stash-s/FunkNetzWerkUhr/README.md

# FunkNetzWerkUhr
ESP8266 IN-12 Nixie lamp netwok clock
