stash-s/FunkNetzWerkUhr/kicad/ausf_b/output/nixie-breakout-F.Cu.dxf

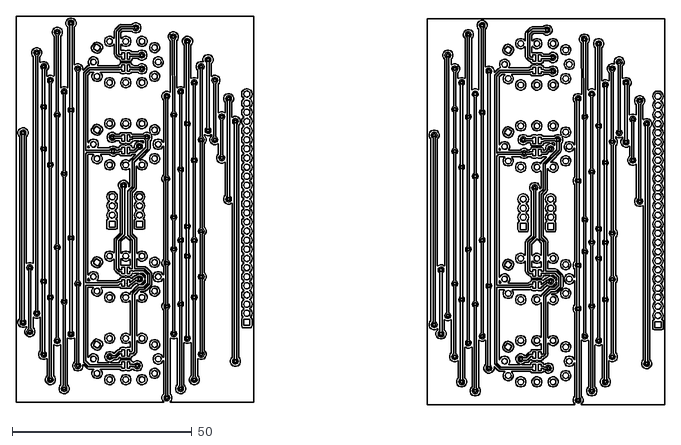
[picture p1: CAD file, 2018-07-26]
kicad/ausf_b/output/nixie-breakout-F.Cu.dxf
180.3 x 107.9
