stash-s/FunkNetzWerkUhr/kicad/ausf_b/output/hv_psu-hv_psu.pdf

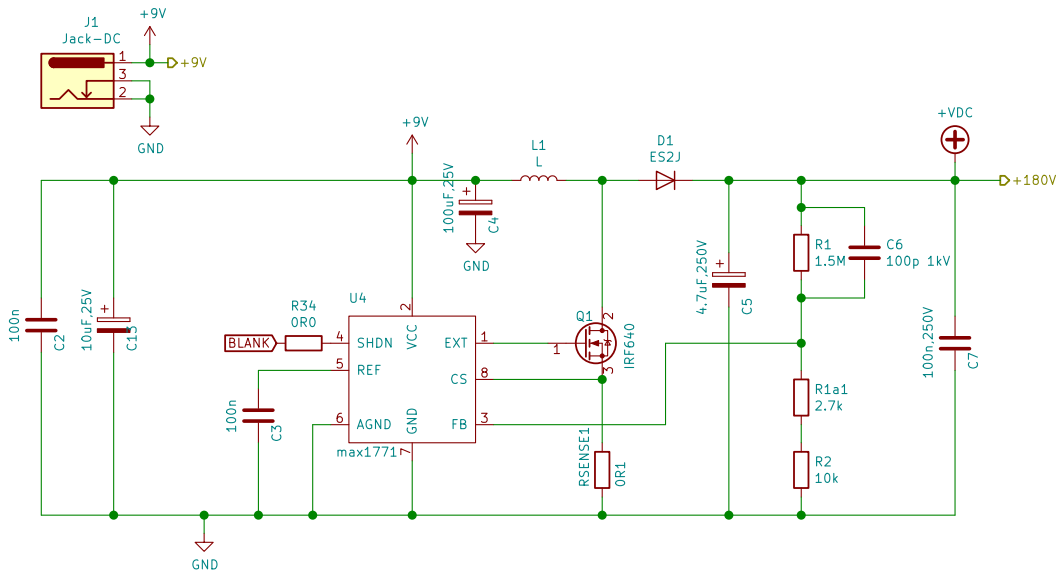
[picture p3: page 1]

2 FB 3 SHDN 4 REF 5 AGND 6 GND
