stash-s/FunkNetzWerkUhr/kicad/ausf_b/output/front_panel-front_panel.pdf

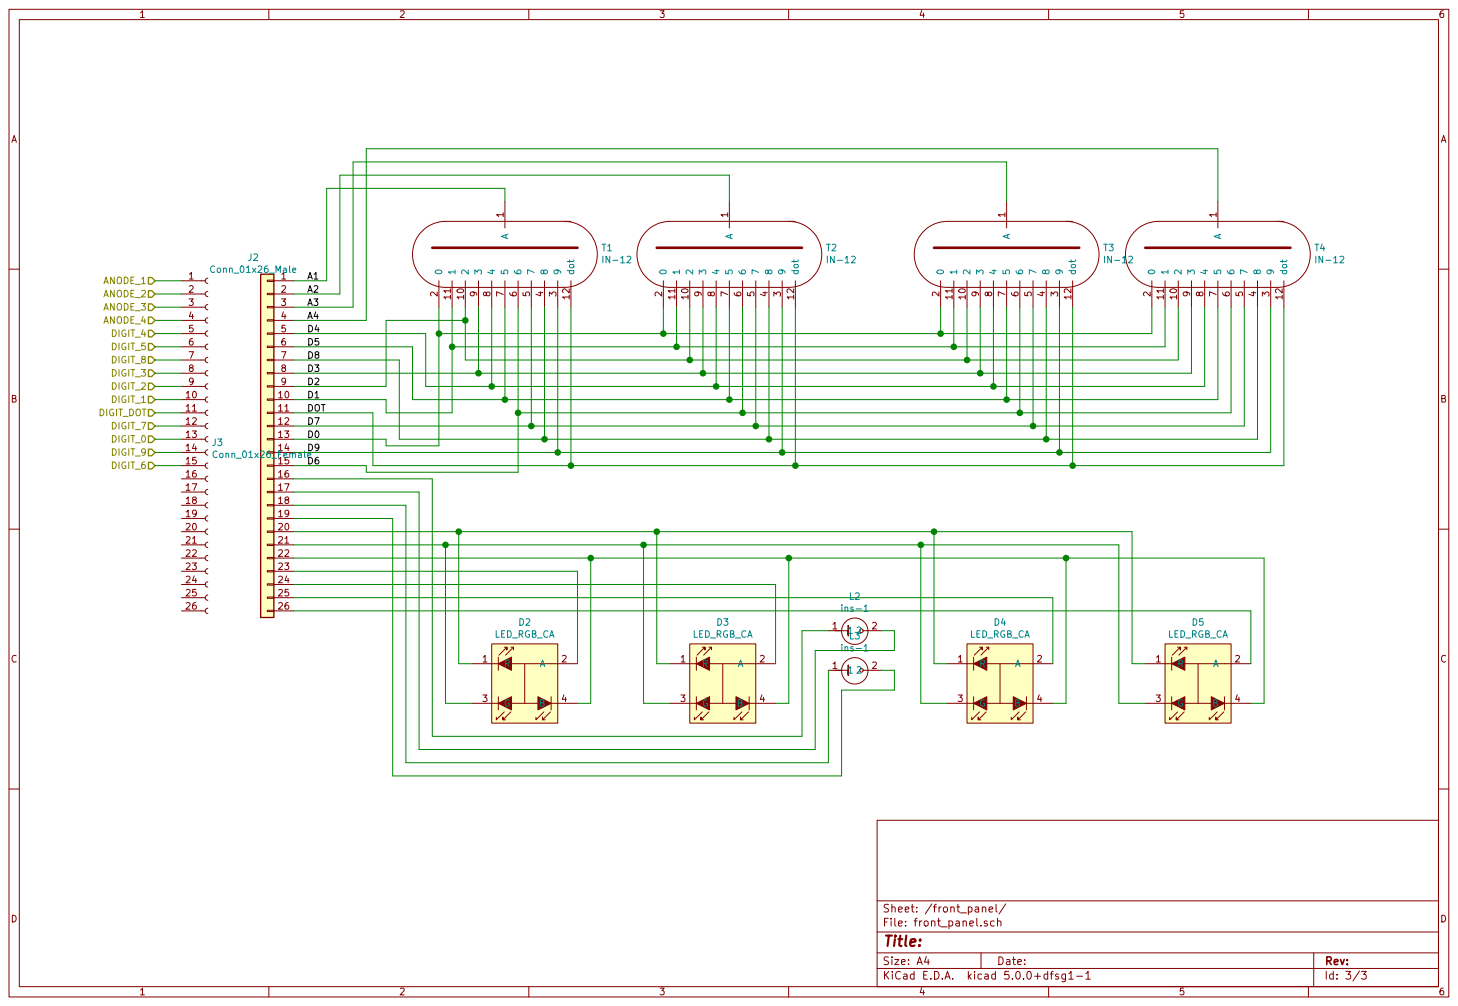
[picture p4: page 1]

21
22
23 | L2
24
25
26 | | ins-1
