stash-s/FunkNetzWerkUhr/kicad/ausf_b/output/funknetzwerkuhr-F.SilkS.pdf

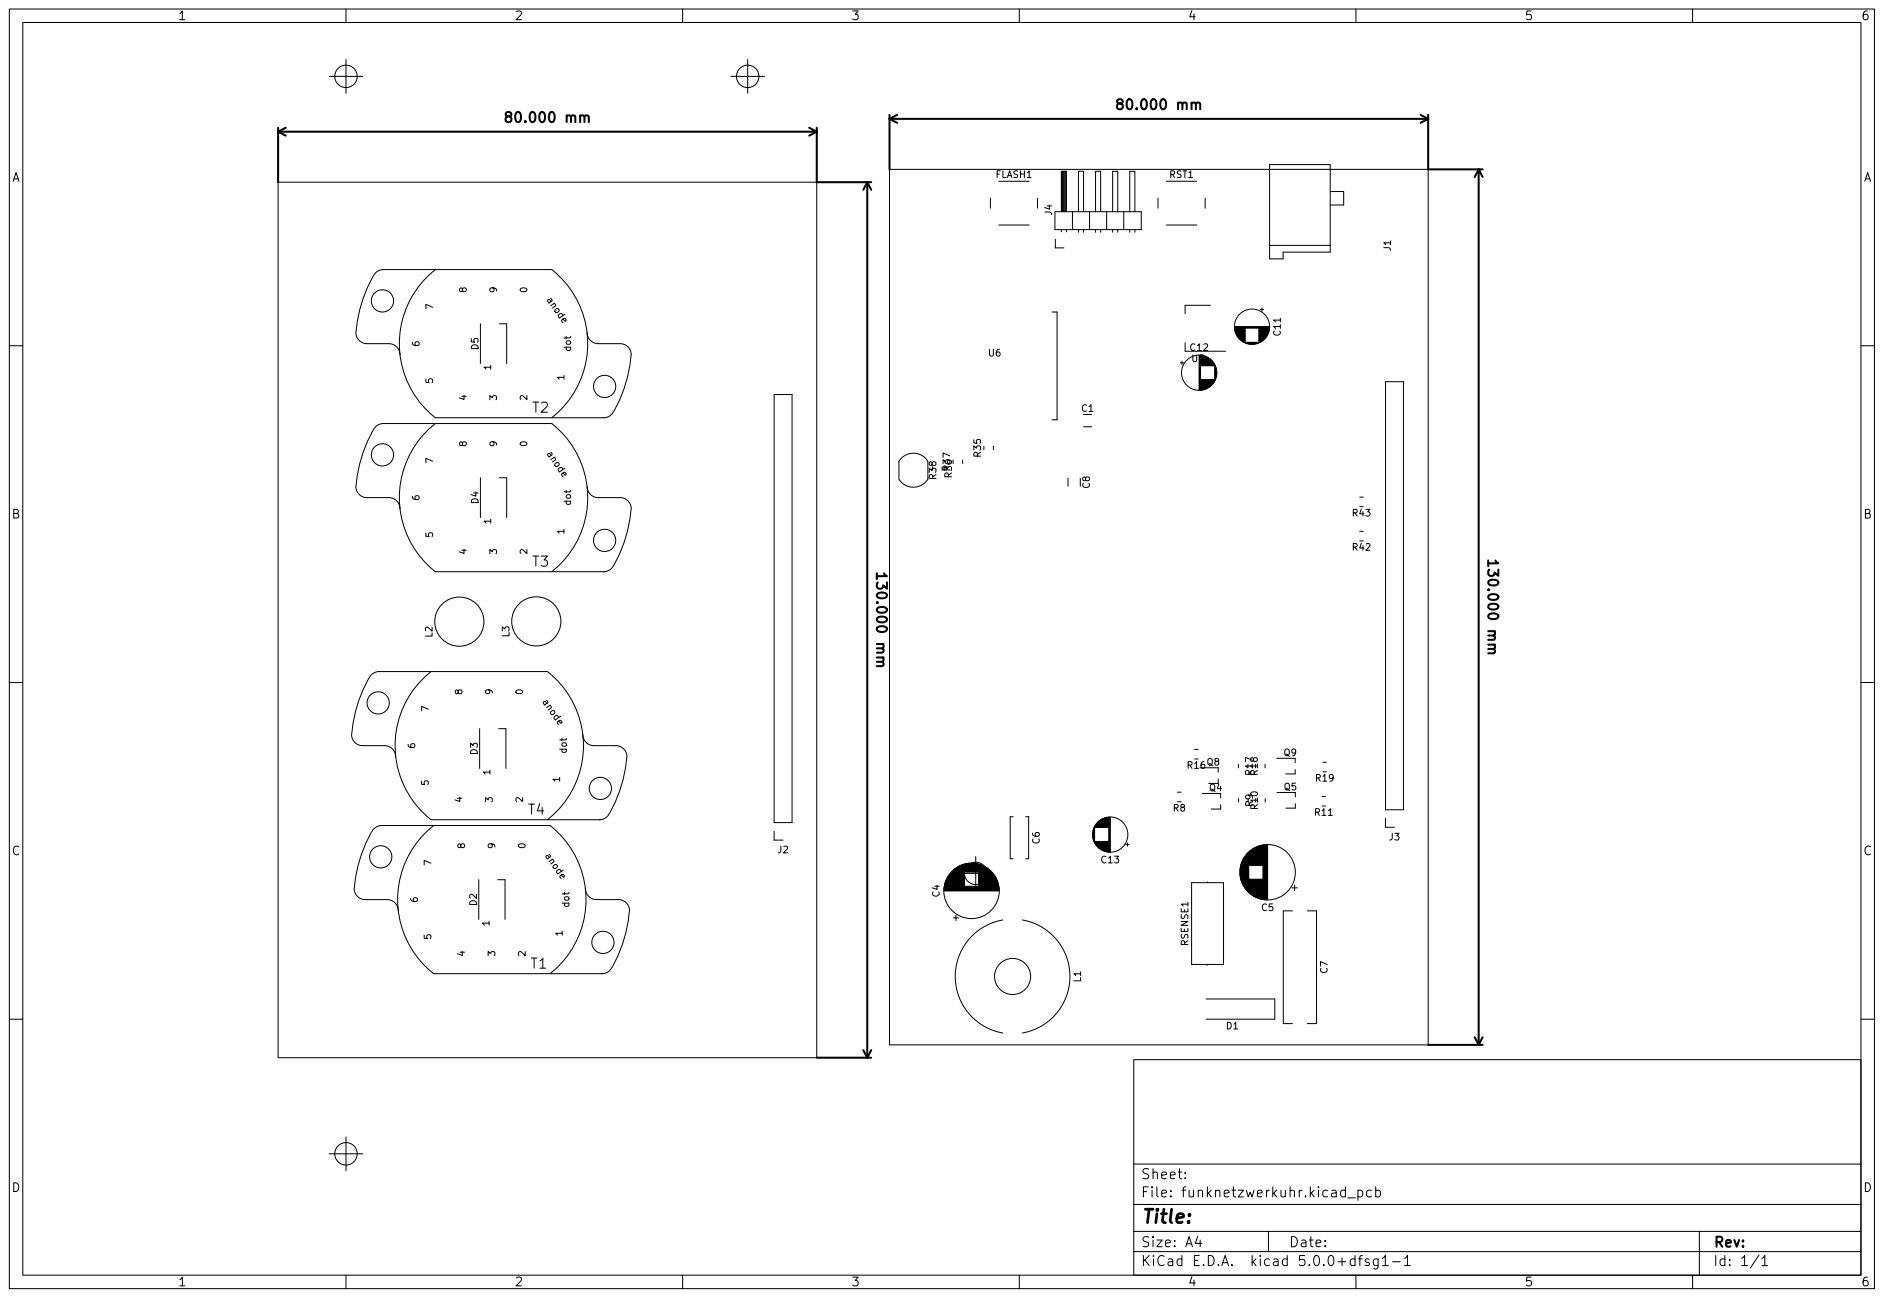
[picture p5: page 1]
