stash-s/FunkNetzWerkUhr/kicad/ausf_b/output/funknetzwerkuhr-transparency.pdf

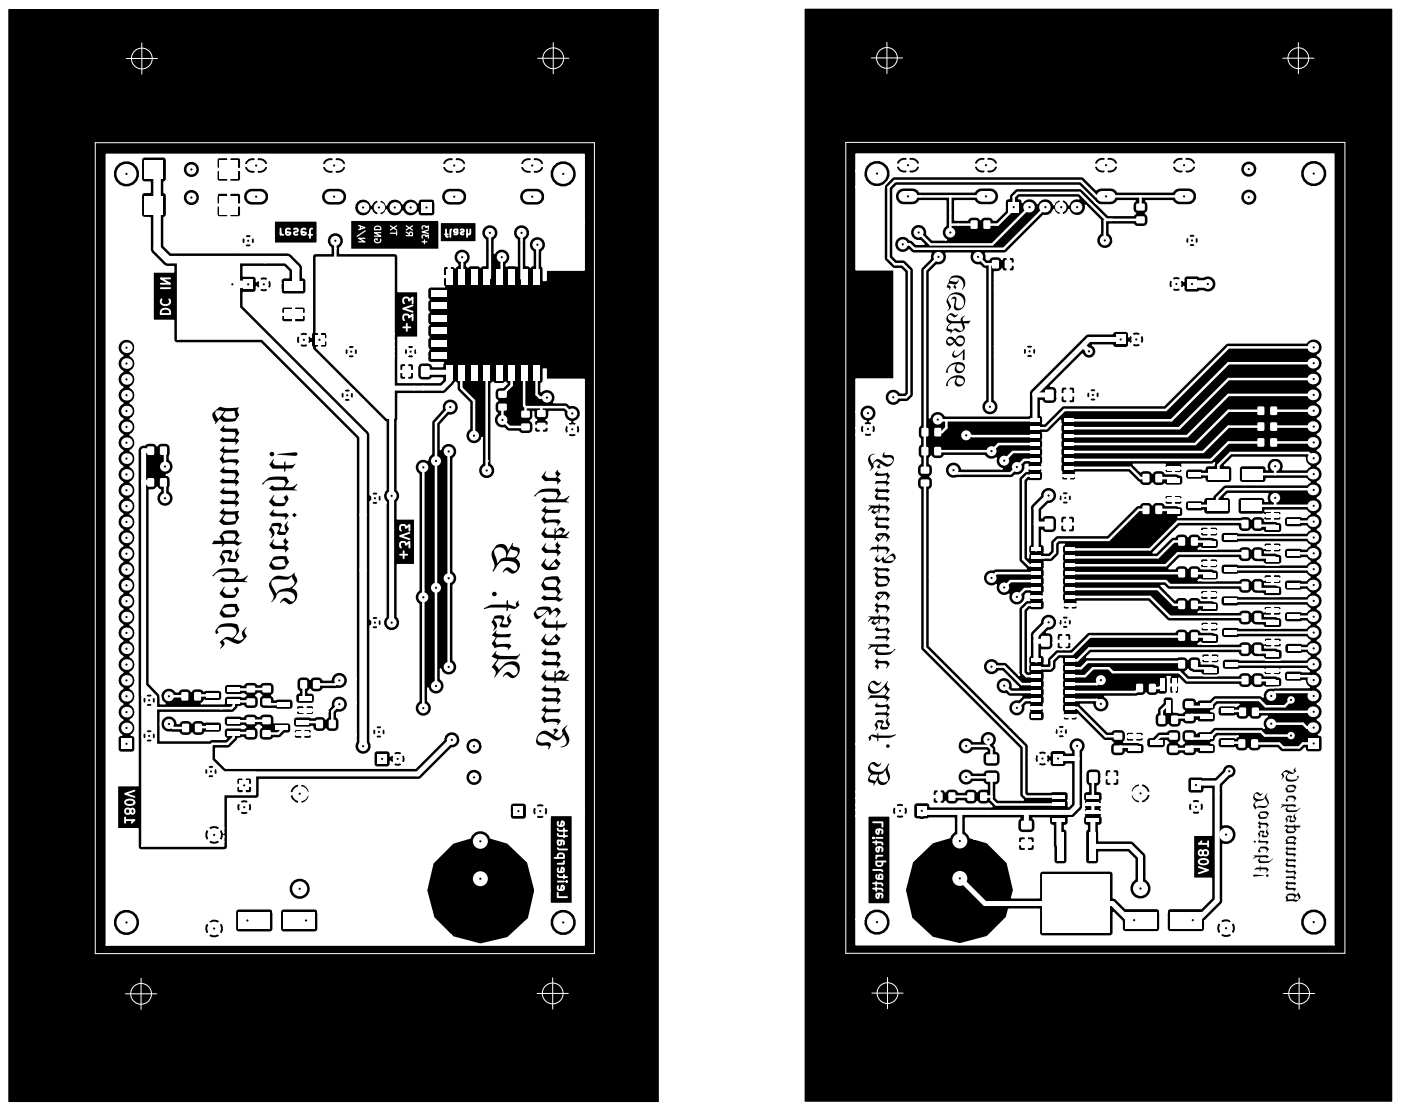
[picture p6: page 1]
