stash-s/FunkNetzWerkUhr/kicad/ausf_b/output/nixie-breakout-B.Cu.pdf

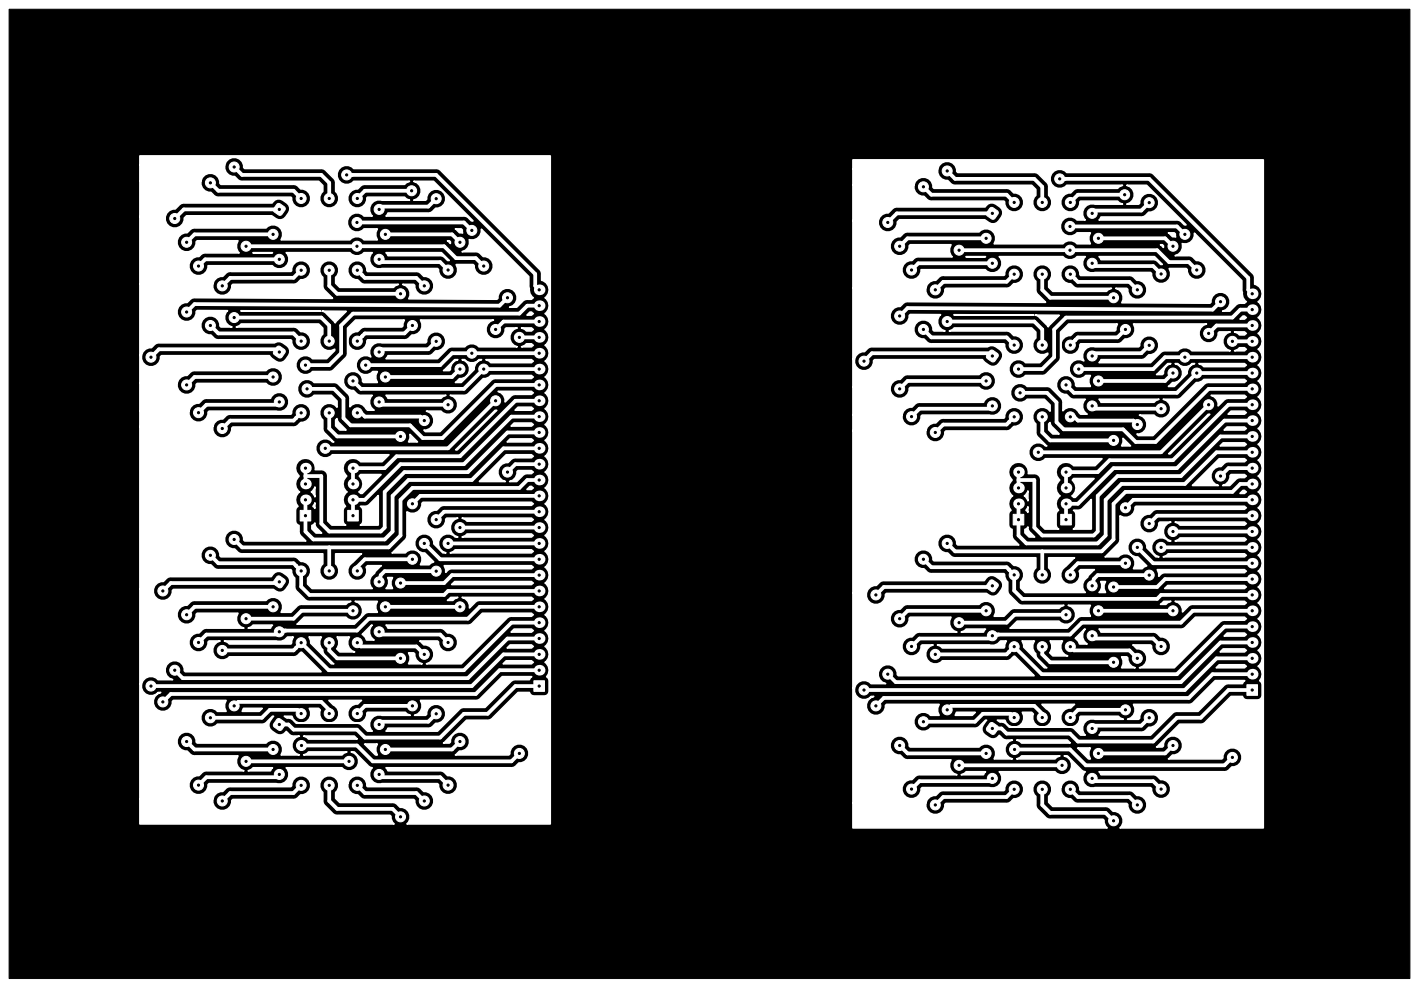
[picture p7: page 1]
