stash-s/FunkNetzWerkUhr/kicad/ausf_b/output/nixie-breakout-F.Cu.pdf

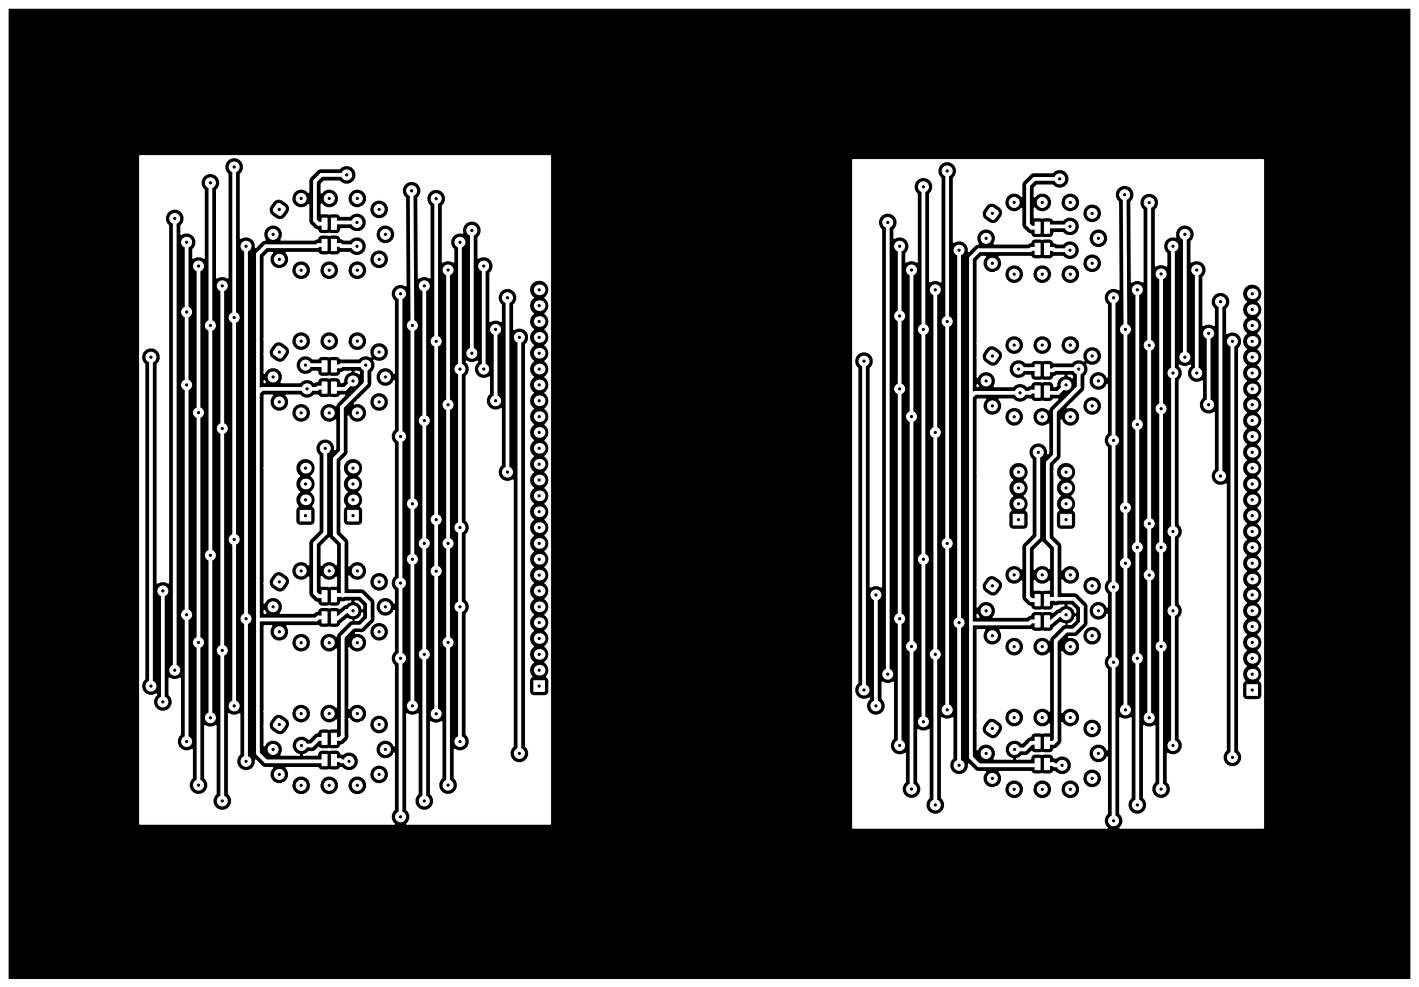
[picture p8: page 1]
