stash-s/FunkNetzWerkUhr/kicad/ausf_c/funknetzwerkuhr.kicad_pcb

## KiCad design kicad/ausf_c/funknetzwerkuhr.kicad_pcb (2022-11-16)

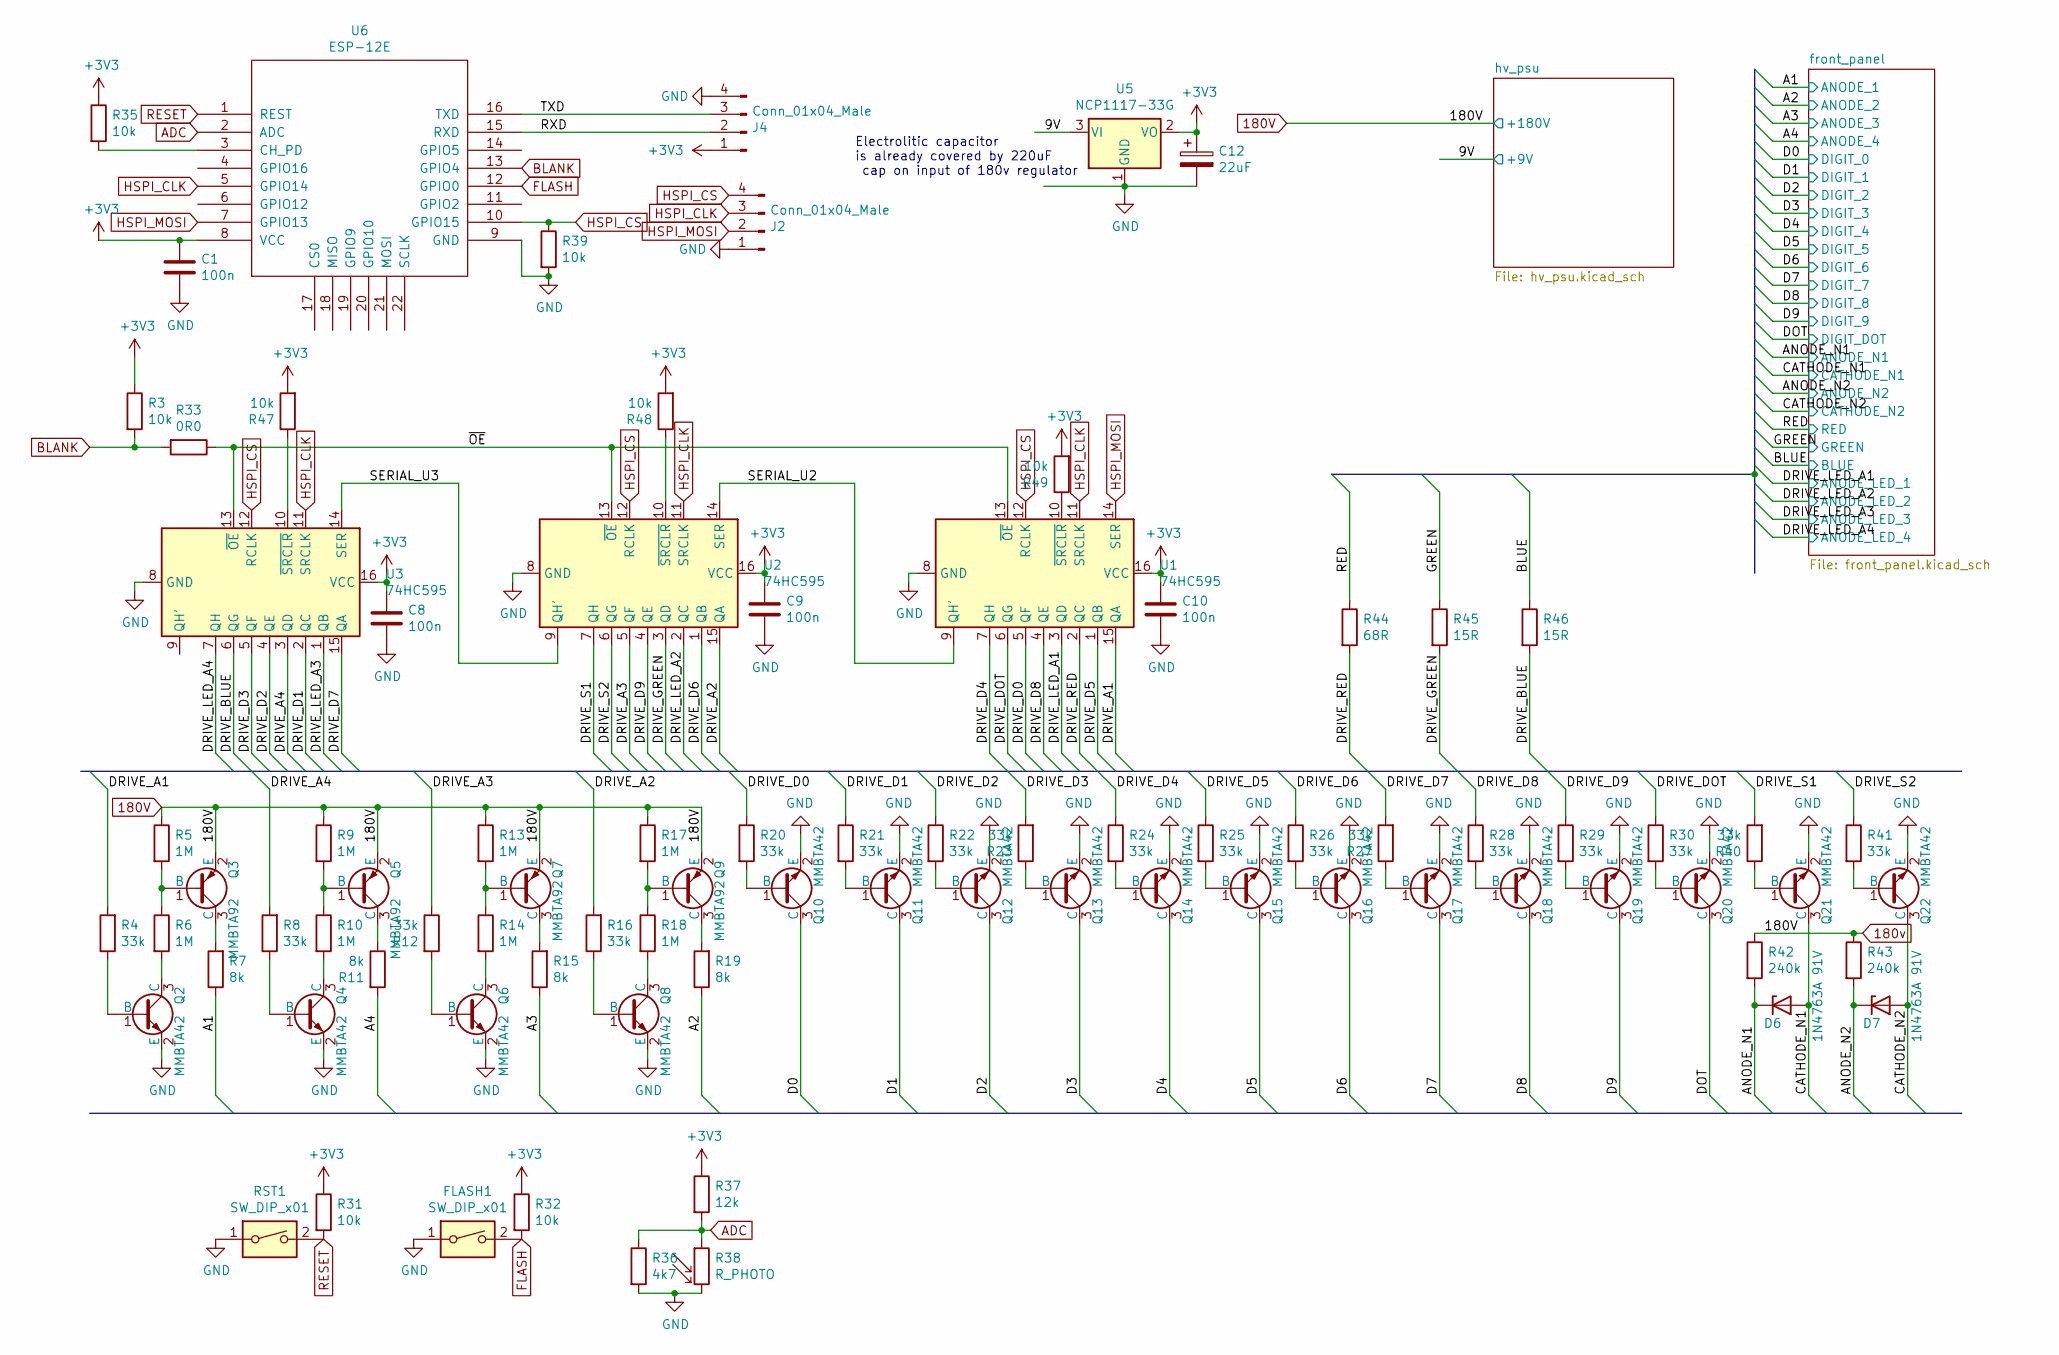
[picture p9: schematic funknetzwerkuhr.kicad_sch]

Parts:
C1, C8, C9, C10: 100n; C_1206_3216Metric_Pad1.42x1.75mm_HandSolder
C12: 22uF; CP_Radial_D6.3mm_P2.50mm
D6, D7: 1N4763A 91V; D_MiniMELF_Handsoldering
FLASH1: SW_DIP_x01; SW_PUSH-12mm
J2: Conn_01x04_Male; PinHeader_1x04_P2.54mm_Vertical
J4: Conn_01x04_Male; PinHeader_1x04_P2.54mm_Horizontal
Q2, Q4, Q6, Q8, Q10, Q11, Q12, Q13, Q14, Q15, Q16, Q17, Q18, Q19, Q20, Q21, Q22: MMBTA42; MPSA42-TSOT-23_HandSoldering
Q3, Q5, Q7, Q9: MMBTA92; MPSA92-TSOT-23_HandSoldering
R3, R31, R32, R35, R39, R47, R48, R49: 10k; R_0805_2012Metric_Pad1.15x1.40mm_HandSolder_Value
R4, R8, R12, R16, R20, R21, R22, R23, R24, R25, R26, R27, R28, R29, R30, R40, R41: 33k; R_0805_2012Metric_Pad1.15x1.40mm_HandSolder_Value
R5, R6, R9, R10, R13, R14, R17, R18: 1M; R_0805_2012Metric_Pad1.15x1.40mm_HandSolder_Value
R7, R11, R15, R19: 8k; R_0805_2012Metric_Pad1.15x1.40mm_HandSolder_Value
R33: 0R0; R_0805_2012Metric_Pad1.15x1.40mm_HandSolder_Value
R36: 4k7; R_0805_2012Metric_Pad1.15x1.40mm_HandSolder_Value
R37: 12k; R_0805_2012Metric_Pad1.15x1.40mm_HandSolder_Value
R38: R_PHOTO; R_LDR_4.9x4.2mm_P2.54mm_Vertical
R42, R43: 240k; R_0805_2012Metric_Pad1.15x1.40mm_HandSolder_Value
R44: 68R; R_0805_2012Metric_Pad1.15x1.40mm_HandSolder_Value
R45, R46: 15R; R_0805_2012Metric_Pad1.15x1.40mm_HandSolder_Value
RST1: SW_DIP_x01; SW_PUSH-12mm
U1, U2, U3: 74HC595; SOIC-16_3.9x9.9mm_P1.27mm
U5: NCP1117-33G; DPACK2
U6: ESP-12E; ESP-12E_SMD

Connections:
180V: Q3.2 (E), Q5.2 (E), Q7.2 (E), Q9.2 (E), R5.1, R9.1, R13.1, R17.1, R42.1, R43.1; also elsewhere on the board
+3V3: C1.1, C8.1, C9.1, C10.1, C12.1, J4.1, R3.1, R31.1, R32.1, R35.1, R37.1, R47.2, R48.2, R49.2, U1.16 (VCC), U2.16 (VCC), U3.16 (VCC), U5.2 (VO), U6.8 (VCC)
+9V: U5.3 (VI); also elsewhere on the board
/A1: R7.1; also elsewhere on the board
/A2: R19.1; also elsewhere on the board
/A3: R15.1; also elsewhere on the board
/A4: R11.2; also elsewhere on the board
/ANODE_N1: D6.1 (K), R42.2; also elsewhere on the board
/ANODE_N2: D7.1 (K), R43.2; also elsewhere on the board
/BLUE: R46.1; also elsewhere on the board
/CATHODE_N1: D6.2 (A), Q21.3 (C); also elsewhere on the board
/CATHODE_N2: D7.2 (A), Q22.3 (C); also elsewhere on the board
/D0: Q10.3 (C); also elsewhere on the board
/D1: Q11.3 (C); also elsewhere on the board
/D2: Q12.3 (C); also elsewhere on the board
/D3: Q13.3 (C); also elsewhere on the board
/D4: Q14.3 (C); also elsewhere on the board
/D5: Q15.3 (C); also elsewhere on the board
/D6: Q16.3 (C); also elsewhere on the board
/D7: Q17.3 (C); also elsewhere on the board
/D8: Q18.3 (C); also elsewhere on the board
/D9: Q19.3 (C); also elsewhere on the board
/DOT: Q20.3 (C); also elsewhere on the board
/DRIVE_A1: R4.2, U1.15 (QA)
/DRIVE_A2: R16.2, U2.15 (QA)
/DRIVE_A3: R12.1, U2.5 (QF)
/DRIVE_A4: R8.2, U3.3 (QD)
/DRIVE_BLUE: R46.2, U3.6 (QG)
/DRIVE_D0: R20.1, U1.5 (QF)
/DRIVE_D1: R21.1, U3.2 (QC)
/DRIVE_D2: R22.1, U3.4 (QE)
/DRIVE_D3: R23.2, U3.5 (QF)
/DRIVE_D4: R24.1, U1.7 (QH)
/DRIVE_D5: R25.1, U1.1 (QB)
/DRIVE_D6: R26.1, U2.1 (QB)
/DRIVE_D7: R27.2, U3.15 (QA)
/DRIVE_D8: R28.1, U1.4 (QE)
/DRIVE_D9: R29.1, U2.4 (QE)
/DRIVE_DOT: R30.1, U1.6 (QG)
/DRIVE_GREEN: R45.2, U2.3 (QD)
/DRIVE_LED_A1: U1.3 (QD); also elsewhere on the board
/DRIVE_LED_A2: U2.2 (QC); also elsewhere on the board
/DRIVE_LED_A3: U3.1 (QB); also elsewhere on the board
/DRIVE_LED_A4: U3.7 (QH); also elsewhere on the board
/DRIVE_RED: R44.2, U1.2 (QC)
/DRIVE_S1: R40.2, U2.7 (QH)
/DRIVE_S2: R41.1, U2.6 (QG)
/GREEN: R45.1; also elsewhere on the board
/RED: R44.1; also elsewhere on the board
/RXD: J4.2, U6.15 (RXD)
/SERIAL_U2: U1.9 (QH'), U2.14 (SER)
/SERIAL_U3: U2.9 (QH'), U3.14 (SER)
/TXD: J4.3, U6.16 (TXD)
/~OE: R33.1, U1.13 (~OE), U2.13 (~OE), U3.13 (~OE)
ADC: R36.1, R37.2, R38.1, U6.2 (ADC)
BLANK: R3.2, R33.2, U6.13 (GPIO4); also elsewhere on the board
FLASH: FLASH1.2, R32.2, U6.12 (GPIO0)
GND: C1.2, C8.2, C9.2, C10.2, C12.2, FLASH1.1, J2.1, J4.4, Q2.2 (E), Q4.2 (E), Q6.2 (E), Q8.2 (E), Q10.2 (E), Q11.2 (E), Q12.2 (E), Q13.2 (E), Q14.2 (E), Q15.2 (E), Q16.2 (E), Q17.2 (E), Q18.2 (E), Q19.2 (E), Q20.2 (E), Q21.2 (E), Q22.2 (E), R36.2, R38.2, R39.2, RST1.1, U1.8 (GND), U2.8 (GND), U3.8 (GND), U5.1 (GND), U6.9 (GND); also elsewhere on the board
HSPI_CLK: J2.3, U1.11 (SRCLK), U2.11 (SRCLK), U3.11 (SRCLK), U6.5 (GPIO14)
HSPI_CS: J2.4, R39.1, U1.12 (RCLK), U2.12 (RCLK), U3.12 (RCLK), U6.10 (GPIO15)
HSPI_MOSI: J2.2, U1.14 (SER), U6.7 (GPIO13)
unnamed: Q2.1 (B), R4.1
unnamed: Q2.3 (C), R6.2
unnamed: Q3.1 (B), R5.2, R6.1
unnamed: Q3.3 (C), R7.2
unnamed: Q4.1 (B), R8.1
unnamed: Q4.3 (C), R10.2
unnamed: Q5.1 (B), R9.2, R10.1
unnamed: Q5.3 (C), R11.1
unnamed: Q6.1 (B), R12.2
unnamed: Q6.3 (C), R14.2
unnamed: Q7.1 (B), R13.2, R14.1
unnamed: Q7.3 (C), R15.2
unnamed: Q8.1 (B), R16.1
unnamed: Q8.3 (C), R18.2
unnamed: Q9.1 (B), R17.2, R18.1
unnamed: Q9.3 (C), R19.2
unnamed: Q10.1 (B), R20.2
unnamed: Q11.1 (B), R21.2
unnamed: Q12.1 (B), R22.2
unnamed: Q13.1 (B), R23.1
unnamed: Q14.1 (B), R24.2
unnamed: Q15.1 (B), R25.2
unnamed: Q16.1 (B), R26.2
unnamed: Q17.1 (B), R27.1
unnamed: Q18.1 (B), R28.2
unnamed: Q19.1 (B), R29.2
unnamed: Q20.1 (B), R30.2
unnamed: Q21.1 (B), R40.1
unnamed: Q22.1 (B), R41.2
unnamed: R35.2, U6.3 (CH_PD)
unnamed: R47.1, U3.10 (~SRCLR)
unnamed: R48.1, U2.10 (~SRCLR)
unnamed: R49.1, U1.10 (~SRCLR)
RESET: R31.2, RST1.2, U6.1 (REST)

Notes on the sheet:
Electrolitic capacitor is already covered by 220uF cap on input of 180v regulator

Schematic: hv_psu.kicad_sch

Parts:
C2, C3: 100n; C_1206_3216Metric_Pad1.42x1.75mm_HandSolder
C4: 220uF,25V; CP_Radial_D10.0mm_P2.50mm_P5.00mm
C5: 4.7uF,250V; CP_Radial_D8.0mm_P3.50mm
C7: 100n,250V; C_Rect_L16.5mm_W4.7mm_P15.00mm_MKT
D1: ES2J; D_SMB_Handsoldering
J1: Jack-DC; AliExpress55mmBarelJack
J3: Conn_01x02_Male; PinHeader_1x02_P2.54mm_Vertical
L1: L; L_Toroid_Vertical_L14.0mm_W6.3mm_P4.57mm_Pulse_A
Q1: IRF640; TO-263-2
R1: 1.5M; R_1206_3216Metric_Pad1.42x1.75mm_HandSolder
R1a1: 2.7k; R_0805_2012Metric_Pad1.15x1.40mm_HandSolder_Value
R2: 10k; R_0805_2012Metric_Pad1.15x1.40mm_HandSolder_Value
R34: 0R0; R_0805_2012Metric_Pad1.15x1.40mm_HandSolder_Value
RSENSE1: 0R1; R_2512_6332Metric_Pad1.52x3.35mm_HandSolder
U4: max1771; PowerIntegrations_SO-8

Connections:
180V: C5.1, C7.1, D1.1 (K), J3.2, R1.1; also elsewhere on the board
+9V: C2.1, C4.1, J1.1, L1.1, U4.2 (VCC); also elsewhere on the board
/hv_psu/SENSE: Q1.3 (S), RSENSE1.1, U4.8 (CS)
BLANK: R34.2; also elsewhere on the board
GND: C2.2, C3.2, C4.2, C5.2, C7.2, J1.2, J1.3, J3.1, R2.2, RSENSE1.2, U4.6 (AGND), U4.7 (GND); also elsewhere on the board
unnamed: C3.1, U4.5 (REF)
unnamed: D1.2 (A), L1.2, Q1.2 (D)
unnamed: Q1.1 (G), U4.1 (EXT)
unnamed: R1.2, R1a1.1, U4.3 (FB)
unnamed: R1a1.2, R2.1
unnamed: R34.1, U4.4 (SHDN)

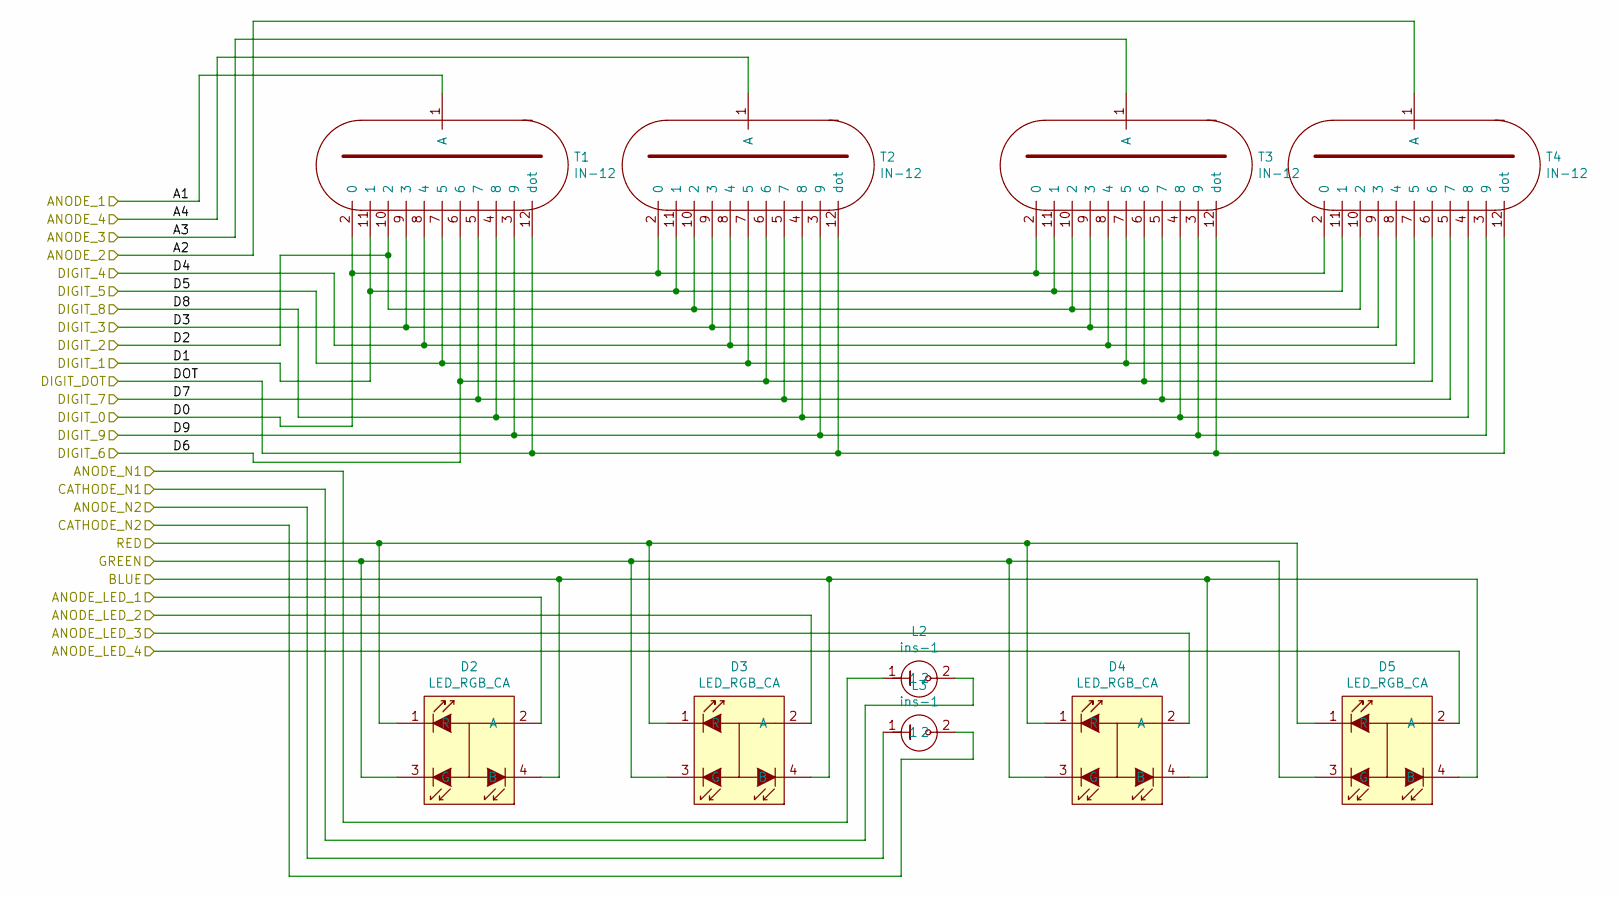
[picture p10: schematic front_panel.kicad_sch]

Parts:
D2, D3, D4, D5: LED_RGB_CA; LED_3528_3.5x2.8mm
L2, L3: ins-1
T1, T2, T3, T4: IN-12; IN-12_0.8mm_simple

Connections:
/A1: T1.1 (A); also elsewhere on the board
/A2: T4.1 (A); also elsewhere on the board
/A3: T3.1 (A); also elsewhere on the board
/A4: T2.1 (A); also elsewhere on the board
/ANODE_N1: L2.1; also elsewhere on the board
/ANODE_N2: L3.1; also elsewhere on the board
/BLUE: D2.4 (B), D3.4 (B), D4.4 (B), D5.4 (B); also elsewhere on the board
/CATHODE_N1: L2.2; also elsewhere on the board
/CATHODE_N2: L3.2; also elsewhere on the board
/D0: T1.2 (0), T2.2 (0), T3.2 (0), T4.2 (0); also elsewhere on the board
/D1: T1.11 (1), T2.11 (1), T3.11 (1), T4.11 (1); also elsewhere on the board
/D2: T1.10 (2), T2.10 (2), T3.10 (2), T4.10 (2); also elsewhere on the board
/D3: T1.9 (3), T2.9 (3), T3.9 (3), T4.9 (3); also elsewhere on the board
/D4: T1.8 (4), T2.8 (4), T3.8 (4), T4.8 (4); also elsewhere on the board
/D5: T1.7 (5), T2.7 (5), T3.7 (5), T4.7 (5); also elsewhere on the board
/D6: T1.6, T2.6, T3.6, T4.6; also elsewhere on the board
/D7: T1.5 (7), T2.5 (7), T3.5 (7), T4.5 (7); also elsewhere on the board
/D8: T1.4 (8), T2.4 (8), T3.4 (8), T4.4 (8); also elsewhere on the board
/D9: T1.3 (9), T2.3 (9), T3.3 (9), T4.3 (9); also elsewhere on the board
/DOT: T1.12 (dot), T2.12 (dot), T3.12 (dot), T4.12 (dot); also elsewhere on the board
/DRIVE_LED_A1: D2.2 (A); also elsewhere on the board
/DRIVE_LED_A2: D3.2 (A); also elsewhere on the board
/DRIVE_LED_A3: D4.2 (A); also elsewhere on the board
/DRIVE_LED_A4: D5.2 (A); also elsewhere on the board
/GREEN: D2.3 (G), D3.3 (G), D4.3 (G), D5.3 (G); also elsewhere on the board
/RED: D2.1 (R), D3.1 (R), D4.1 (R), D5.1 (R); also elsewhere on the board

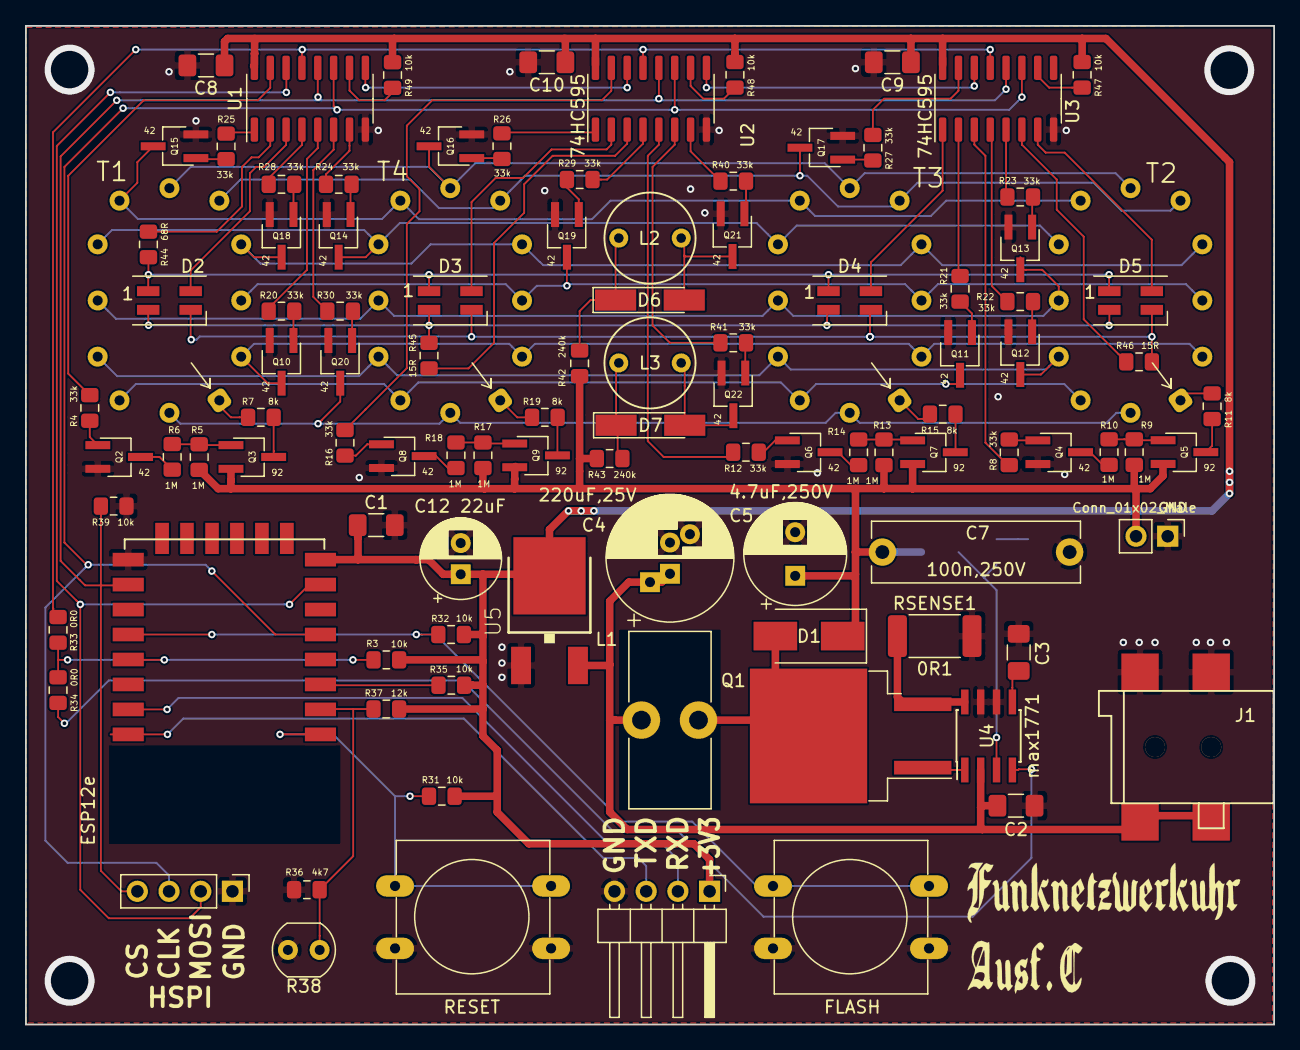
[picture p11: board funknetzwerkuhr.kicad_pcb from above]

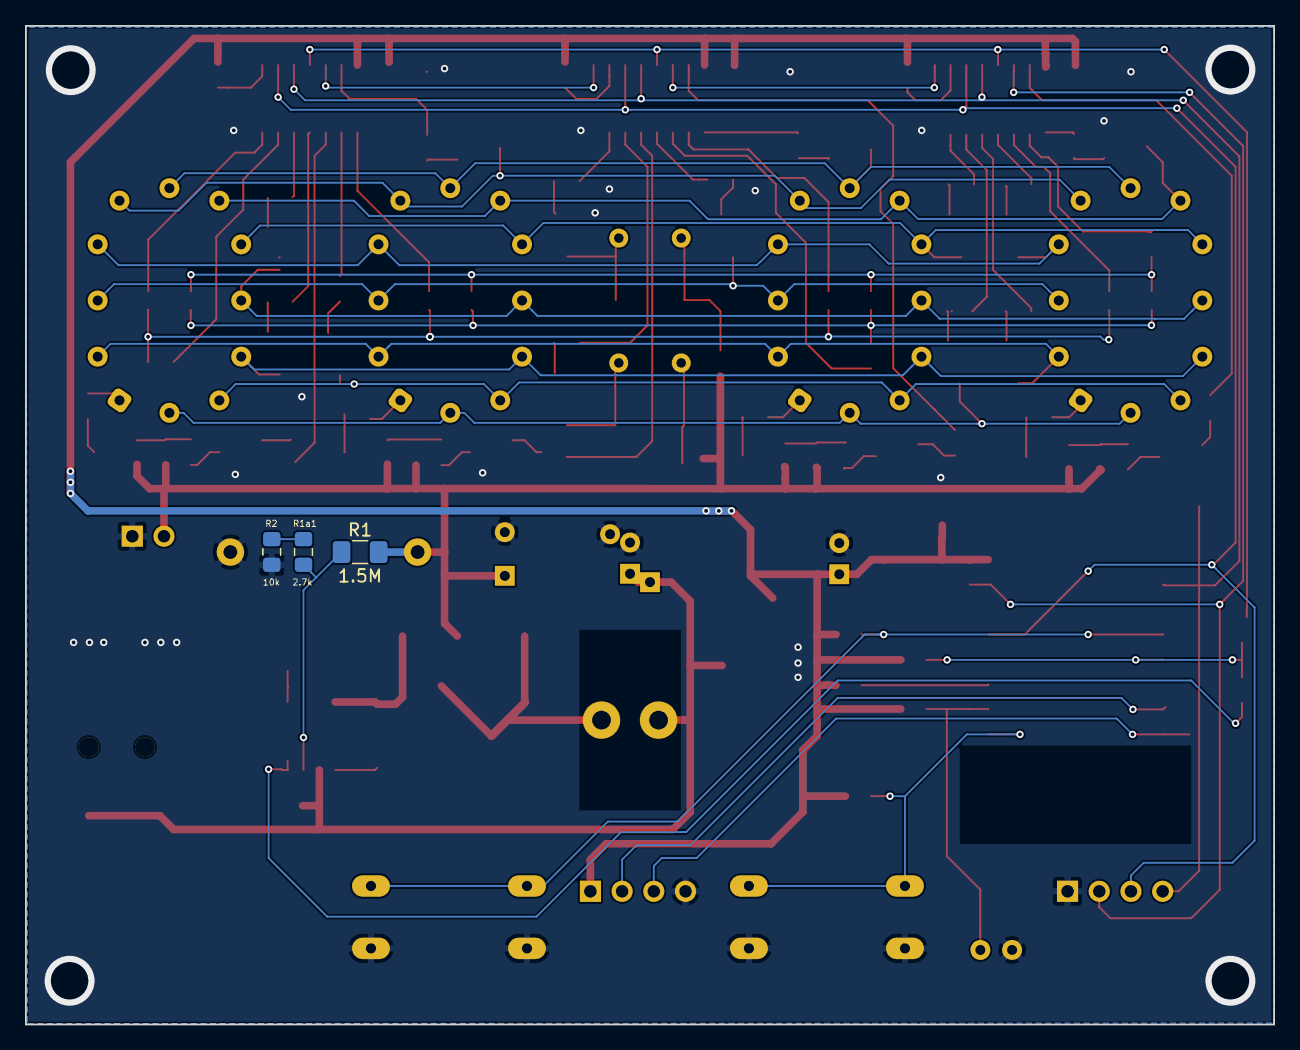
[picture p12: board funknetzwerkuhr.kicad_pcb from below]

Board: 2 copper layers, 100.0 x 80.0 mm, 109 parts (3 on the bottom side), 102 nets.
