stash-s/FunkNetzWerkUhr/kicad/ausf_d/ausf_d.kicad_pcb

## KiCad design kicad/ausf_d/ausf_d.kicad_pcb (2020-11-04)

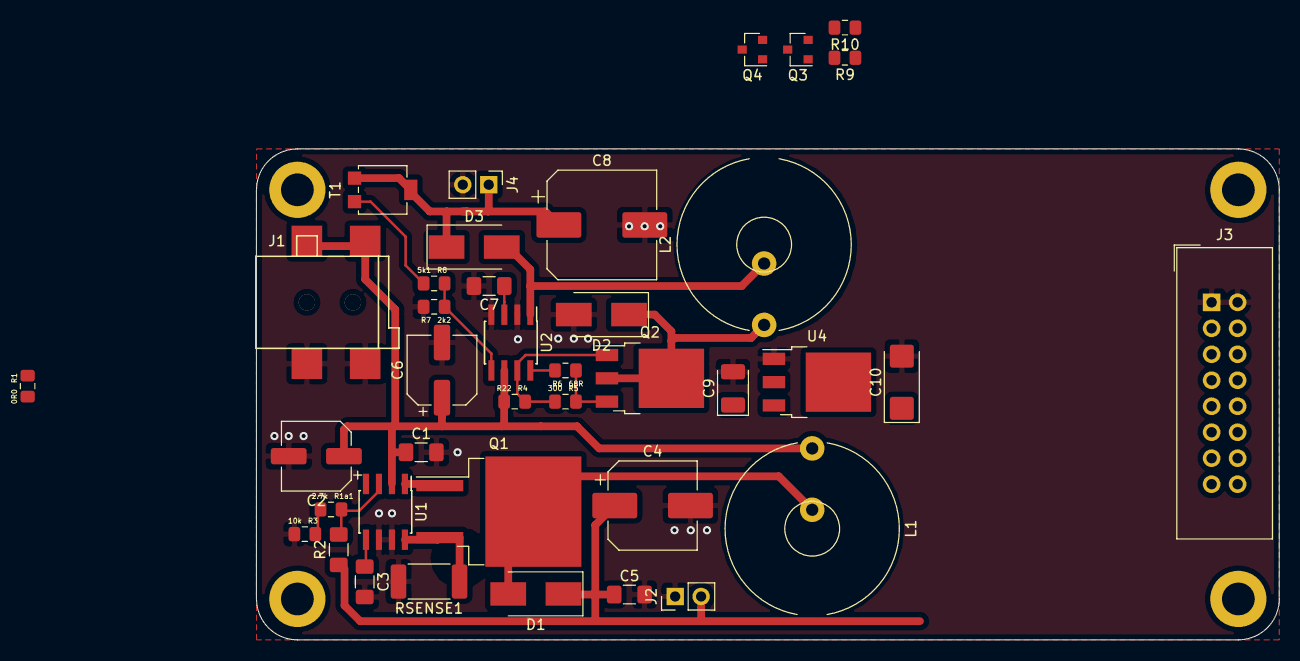
[picture p13: board ausf_d.kicad_pcb from above]

Board: 2 copper layers, 100.0 x 48.0 mm, 40 parts (1 on the bottom side), 26 nets.

Parts:
C1, C3: 100n; C_1206_3216Metric_Pad1.42x1.75mm_HandSolder
C2: 220uF,25V; CP_Elec_6.3x7.7
C4: 4.7uF,250V; CP_Elec_8x10.5
C5: 100n,250V; C_1206_3216Metric_Pad1.42x1.75mm_HandSolder
C6: 100; CP_Elec_6.3x7.7
C7: 470pF; C_1206_3216Metric_Pad1.42x1.75mm_HandSolder
C8: 330; CP_Elec_10x14.3
C9: 10u; CP_EIA-3528-12_Kemet-T_Pad1.50x2.35mm_HandSolder
C10: 22u; CP_EIA-6032-28_Kemet-C_Pad2.25x2.35mm_HandSolder
D1: ES2J; D_SMB_Handsoldering
D2, D3: SS16T3G; D_SMB_Handsoldering
J1: Jack-DC; AliExpress55mmBarrelJack
J2: Conn_01x02_Male; PinHeader_1x02_P2.54mm_Vertical
J3: Conn_02x10_Odd_Even; IDC-Header_2x08_P2.54mm_Vertical
J4: Conn_01x02; PinHeader_1x02_P2.54mm_Vertical
L1: L; L_Toroid_Horizontal_D16.8mm_P6mm_AliExpress
L2: 300uH; L_Toroid_Horizontal_D16.8mm_P6mm_AliExpress
Q1: IRF640; TO-263-2
Q2: 2SD669AD-C; TO-252-3_TabPin2
Q3, Q4: BC847; SOT-23
R1: 0R0; R_0805_2012Metric_Pad1.15x1.40mm_HandSolder_Value
R1a1: 2.7k; R_0805_2012Metric_Pad1.15x1.40mm_HandSolder_Value
R2: 1.5M; R_1206_3216Metric_Pad1.42x1.75mm_HandSolder
R3: 10k; R_0805_2012Metric_Pad1.15x1.40mm_HandSolder_Value
R4: R22; R_0805_2012Metric_Pad1.15x1.40mm_HandSolder_Value
R5: 300; R_0805_2012Metric_Pad1.15x1.40mm_HandSolder_Value
R6: 68R; R_0805_2012Metric_Pad1.15x1.40mm_HandSolder_Value
R7: 2k2; R_0805_2012Metric_Pad1.15x1.40mm_HandSolder_Value
R8: 5k1; R_0805_2012Metric_Pad1.15x1.40mm_HandSolder_Value
R9, R10: 12k; R_0805_2012Metric_Pad1.15x1.40mm_HandSolder
RSENSE1: 0R1; R_2512_6332Metric_Pad1.52x3.35mm_HandSolder
T1: TRIM_EU-S64W; Potentiometer_Bourns_3314G_Vertical
U1: max1771; PowerIntegrations_SO-8
U2: MC34063AP; PowerIntegrations_SO-8
U3: ESP-12F; ESP-12E
U4: AMS1117CD-3.3; TO-252-3_TabPin2

Connections:
+9V: C1.1, C2.1, C6.1, C9.1, J1.1, J3.7, J3.8, L1.1, R4.2, U1.2, U2.6, U4.3
/+3V3: C10.1, J3.5, J3.6, U3.8, U4.2
/+FILAMENT_DC: C8.1, D3.1, J3.3, J3.4, J4.1, T1.1, T1.2
/+HVDC: C4.1, C5.1, D1.1, J2.2, J3.9, J3.10, R2.1
/DTR: Q4.2, R9.1
/GPIO0: Q4.3, U3.18
/RST: Q3.3, U3.1
/RTS: Q3.2, R10.1
/hv_psu/SENSE: Q1.3, RSENSE1.1, U1.8
GND: C1.2, C2.2, C3.2, C4.2, C5.2, C6.2, C7.2, C8.2, C9.2, C10.2, D2.2, J1.2, J1.3, J2.1, J3.1, J3.2, J4.2, R3.2, R7.1, RSENSE1.2, U1.6, U1.7, U2.2, U2.4, U3.15, U4.1
unnamed: C3.1, U1.5
unnamed: C7.1, U2.3
unnamed: D1.2, L1.2, Q1.2
unnamed: D2.1, L2.1, Q2.2
unnamed: D3.2, L2.2, U2.1
unnamed: Q1.1, U1.1
unnamed: Q2.1, R4.1, R5.2, U2.7
unnamed: Q2.3, R5.1, R6.2
unnamed: Q3.1, R9.2
unnamed: Q4.1, R10.2
unnamed: R1.1, U1.4
unnamed: R1a1.1, R2.2, U1.3
unnamed: R1a1.2, R3.1
unnamed: R6.1, U2.8
unnamed: R7.2, R8.1, U2.5
unnamed: R8.2, T1.3
