stash-s/FunkNetzWerkUhr/kicad/ausf_b/nixie-breakout.kicad_pcb

## KiCad design kicad/ausf_b/nixie-breakout.kicad_pcb (2018-07-26)

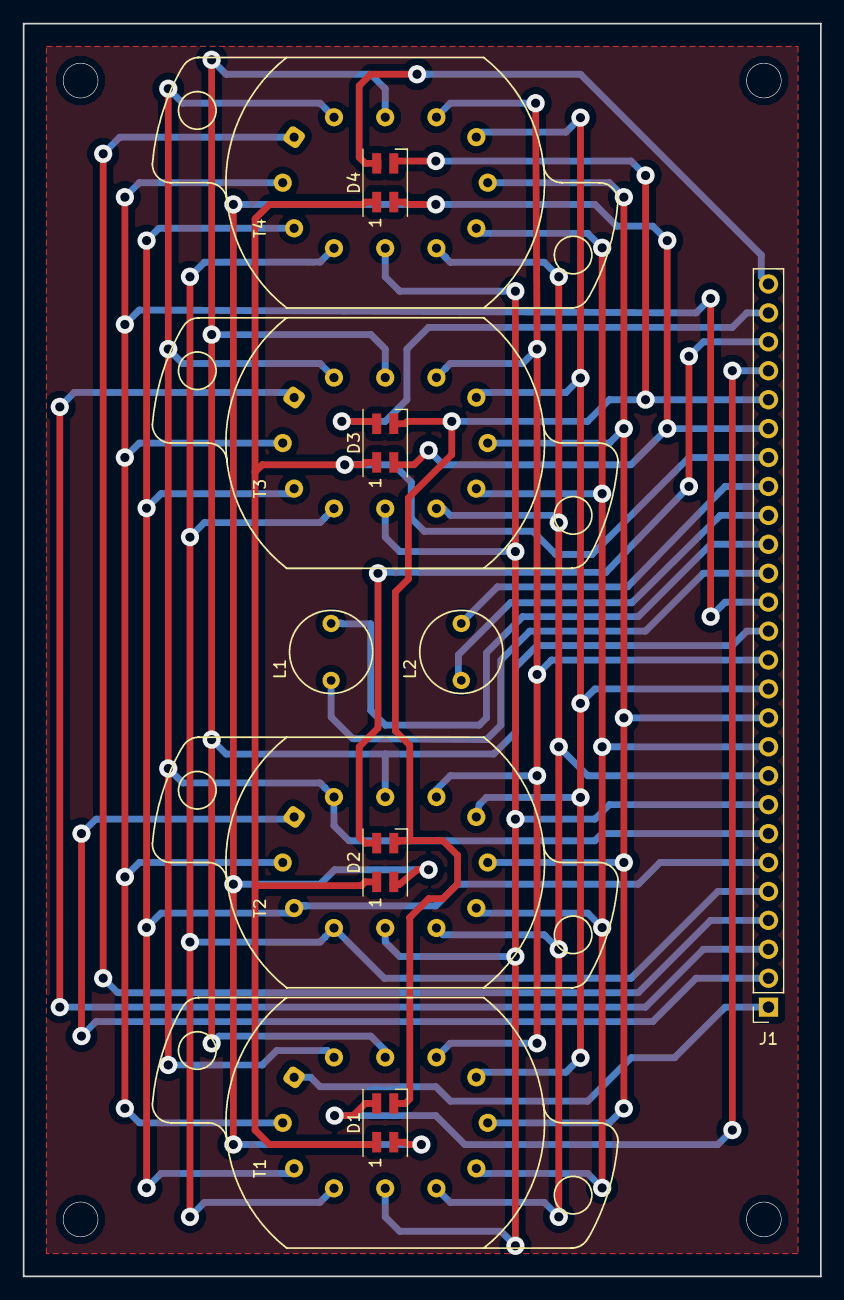
[picture p14: board nixie-breakout.kicad_pcb from above]

Board: 2 copper layers, 70.0 x 110.0 mm, 11 parts (0 on the bottom side), 26 nets.

Parts:
D1, D2, D3, D4: LED_RGB_CA; LED_3528_3.5x2.8mm
J1: Conn_01x26_Male; PinSocket_1x26_P2.54mm_Vertical
L1, L2: ins-1
T1, T2, T3, T4: IN-12; IN-12_0.8mm

Connections:
unnamed: D1.1, D2.1, D3.1, D4.1, J1.20
unnamed: D1.2, J1.23
unnamed: D1.3, D2.3, D3.3, D4.3, J1.21
unnamed: D1.4, D2.4, D3.4, D4.4, J1.22
unnamed: D2.2, J1.24
unnamed: D3.2, J1.25
unnamed: D4.2, J1.26
unnamed: J1.1, T1.1
unnamed: J1.2, T2.1
unnamed: J1.3, T3.1
unnamed: J1.4, T4.1
unnamed: J1.5, T1.10, T2.10, T3.10, T4.10
unnamed: J1.6, T1.11, T2.11, T3.11, T4.11
unnamed: J1.7, T1.2, T2.2, T3.2, T4.2
unnamed: J1.8, T1.9, T2.9, T3.9, T4.9
unnamed: J1.9, T1.8, T2.8, T3.8, T4.8
unnamed: J1.10, T1.7, T2.7, T3.7, T4.7
unnamed: J1.11, T1.6, T2.6, T3.6, T4.6
unnamed: J1.12, T1.5, T2.5, T3.5, T4.5
unnamed: J1.13, T1.4, T2.4, T3.4, T4.4
unnamed: J1.14, T1.3, T2.3, T3.3, T4.3
unnamed: J1.15, T1.12, T2.12, T3.12, T4.12
unnamed: J1.16, L1.1
unnamed: J1.17, L1.2
unnamed: J1.18, L2.1
unnamed: J1.19, L2.2
