stash-s/FunkNetzWerkUhr/funknetzwerkuhr/src/light_sensor.h

#ifndef __LIGHT_SENSOR_H__
#define __LIGHT_SENSOR_H__

#include <functional>

class LightSensor {

public:
    typedef std::function<void(int)> HandlerFunction;

    LightSensor ();
    void onReading (HandlerFunction);
    void onLevelSet (HandlerFunction);
    void handle ();

private:
    HandlerFunction _readingHandler;
    std::function<void(int)> _levelHandler;

};

#endif // __LIGHT_SENSOR_H__
