stash-s/FunkNetzWerkUhr/funknetzwerkuhr/src/max_display.cpp

#include <functional>

#include <SPI.h>

#include "clock_config.h"
#include "max_display.h"

static uint32_t payload = 0;

bool MaxDisplay::_pulse_colors = false;

uint8_t MaxDisplay::_red = 0;
uint8_t MaxDisplay::_green = 0;
uint8_t MaxDisplay::_blue = 0;
uint8_t MaxDisplay::_digits[MAX_DIGITS];
uint8_t MaxDisplay::_pwm = PWM_INIT;
uint8_t MaxDisplay::_slot_effect[MAX_DIGITS] = {0, 0, 0, 0};

int MaxDisplay::dots_state = 0;

static int display_timer_divider = 0;

IRAM_ATTR
inline void setDataBits(uint16_t bits) {
    const uint32_t mask = ~((SPIMMOSI << SPILMOSI) | (SPIMMISO << SPILMISO));
    bits--;
    SPI1U1 = ((SPI1U1 & mask) | ((bits << SPILMOSI) | (bits << SPILMISO)));
}

#ifdef AUSF_B

#define RGB_MASK 0b000011100000000000000000
#define RED_MASK 0b000011000000000000000000
#define GREEN_MASK 0b000010100000000000000000
#define BLUE_MASK 0b000001100000000000000000

static MaxDisplay::payload_t led_mux_map[] = {
    0b000100000000000000000000, // digit 1
    0b001000000000000000000000, // digit 2
    0b010000000000000000000000, // digit 3
    0b100000000000000000000000, // digit 4
};

static MaxDisplay::payload_t dots_map[] = {
    0b000000000000000000000000, // dots off
    0b000000011000000000000000  // dots on
};

static MaxDisplay::payload_t digit_mux_map[] = {
    0b0001, // digit 1
    0b0010, // digit 2
    0b0100, // digit 3
    0b1000, // digit 4
};

static MaxDisplay::payload_t number_mux_map[] = {
    0b1000000000000,   // number 0
    0b1000000000,      // number 1
    0b100000000,       // number 2
    0b10000000,        // number 3
    0b10000,           // number 4
    0b100000,          // number 5
    0b100000000000000, // number 6
    0b100000000000,    // number 7
    0b1000000,         // number 8
    0b10000000000000,  // number 9
    //    0b10000000000, // dot
};

#elif defined(AUSF_C)

#define RGB_MASK 0b001000000001000000000010
#define RED_MASK 0b000000000001000000000010
#define GREEN_MASK 0b001000000000000000000010
#define BLUE_MASK 0b001000000001000000000000

static MaxDisplay::payload_t led_mux_map[] = {
    0b000100000000000000000000, // digit 1
    0b000000000010000000000000, // digit 2
    0b000000000000000001000000, // digit 3
    0b000000000000000000000001, // nope
    //   |   |   |   |   |   |
};

static MaxDisplay::payload_t dots_map[] = {
    0b000000000000000000000000, // dots off
    0b000000000000001100000000  // dots on
};

static MaxDisplay::payload_t digit_mux_map[] = {
    //   |   |   |   |   |   |
    0b100000000000000000000000, // 0b0001, // digit 1
    0b000000001000000000000000, // 0b0010, // digit 2
    0b000000000000010000000000, // 0b0100, // digit 3
    0b000000000000000000010000, // 0b1000, // digit 4
};

static MaxDisplay::payload_t number_mux_map[] = {
    //   |   |   |   |   |   |
    0b000001000000000000000000, // 0b1000000000000, // number 0
    0b000000000000000000100000, // 0b1000000000, // number 1
    0b000000000000000000001000, // 0b100000000, // number 2
    0b000000000000000000000100, // 0b10000000, // number 3
    0b000000010000000000000000, // 0b10000, // number 4
    0b010000000000000000000000, // 0b100000, // number 5
    0b000000000100000000000000, // 0b100000000000000, // number 6
    //   |   |   |   |   |   |
    0b000000000000000010000000, // 0b100000000000, // number 7
    0b000010000000000000000000, // 0b1000000, // number 8
    0b000000000000100000000000, // 0b10000000000000, // number 9
    0b000000100000000000000000, // dot
};

#endif

MaxDisplay::MaxDisplay() {}

void MaxDisplay::setBrightness(uint8_t brightness) { _pwm = brightness; }

IRAM_ATTR
uint8_t get_digit(unsigned int digit) {

    static uint8_t slot_number[] = {4, 2, 6, 9};
    static int counter = 0;

    ++counter;
    if (counter >= display_timer_divider * 16 * 4) {
        counter = 0;

        for (int i = 0; i < MAX_DIGITS; ++i) {
            if (MaxDisplay::_slot_effect[i] > 0) {
                if (MaxDisplay::_pulse_colors &&
                    (MaxDisplay::_digits[i] == slot_number[i])) {
                    --MaxDisplay::_slot_effect[i];
                }
            }

            ++slot_number[i];
            if (slot_number[i] > 9) {
                slot_number[i] = 0;
            }
        }
    }

    if (MaxDisplay::_slot_effect[digit] > 0) {
        return slot_number[digit];
    } else {
        return MaxDisplay::_digits[digit];
    }
}

IRAM_ATTR
void tick(/* arguments */) {
    static int current_digit = 0;
    static int pwm_counter = 0;
    static uint8_t color_counter = 0;

    ++color_counter;

    ++pwm_counter;
    if (pwm_counter >= PWM_MAX) {
        pwm_counter = 0;

        ++current_digit;
        if (current_digit >= MAX_DIGITS) {
            current_digit = 0;
        }
    }


    uint32_t color_mask = RGB_MASK;
    uint32_t number_mask = number_mux_map[get_digit(current_digit)];

    // if pwm counter >= pwm, blank digits
    if (pwm_counter >= MaxDisplay::_pwm) {
        payload = color_mask | number_mask;

    } else {

        if (MaxDisplay::_red > color_counter)
            color_mask &= RED_MASK;
        if (MaxDisplay::_green > color_counter)
            color_mask &= GREEN_MASK;
        if (MaxDisplay::_blue > color_counter)
            color_mask &= BLUE_MASK;

#ifdef FULL_COLOR
        for (auto i : led_mux_map) {
            color_mask |= i;
        }
#else
        color_mask |= led_mux_map[current_digit];
#endif

        payload = dots_map[MaxDisplay::dots_state] |
                  digit_mux_map[current_digit] | color_mask | number_mask;
    }
}

IRAM_ATTR
static void isr_call() {

    tick();

    while (SPI1CMD & SPIBUSY) {
    }

    setDataBits(24);
    SPI1W0 = payload;

    SPI1CMD |= SPIBUSY;
}

void MaxDisplay::init() {
    SPI.begin();
    SPI.setDataMode(SPI_MODE0);
    SPI.setHwCs(true);
    SPI.setBitOrder(LSBFIRST);
    SPI.setFrequency(8000000);

    // tutaj
    // setDataBits (24);

    display_timer_divider =
        (clockCyclesPerMicrosecond() / 16) * 20; // 40us = 25kHz sampling freq

    timer1_isr_init();
    timer1_attachInterrupt(isr_call);
    timer1_enable(TIM_DIV16, TIM_EDGE, TIM_LOOP);
    timer1_write(display_timer_divider);

    pinMode(SHDN_PIN, OUTPUT);
    digitalWrite(SHDN_PIN, LOW);
}

void MaxDisplay::shutdown() { digitalWrite(SHDN_PIN, HIGH); }

void MaxDisplay::setDigit(unsigned int digit, uint8_t value) {
    _digits[digit] = value;
}

void MaxDisplay::setColor(uint8_t red, uint8_t green, uint8_t blue,
                          bool pulse_colors) {
    _red = red;
    _green = green;
    _blue = blue;
    _pulse_colors = pulse_colors;

    if (!_pulse_colors) {
        uint8_t spins = 5;
        for (auto &i : _slot_effect) {
            i = spins;
            spins -= 1;
        }
    }
}

void MaxDisplay::setDot(bool on) {

    if (on != MaxDisplay::dots_state && MaxDisplay::_pulse_colors) {
        MaxDisplay::_red += 1;
        MaxDisplay::_blue += 5;
        MaxDisplay::_green += 3;
    }

    MaxDisplay::dots_state = on;

}
