stash-s/FunkNetzWerkUhr/funknetzwerkuhr/src/display.cpp

#include "display.h"

void Display::setColor (uint8_t, uint8_t, uint8_t, bool) {
    // no-op for timepieces that do not support colors
}

void Display::handle () {

}

void Display::setDot (bool on) {

}
