stash-s/FunkNetzWerkUhr/funknetzwerkuhr/src/spi_wrapper.cpp

#include "spi_wrapper.h"

#include <SPI.h>

void SpiWrapper::init (uint16_t dataBits) {
    SPI.begin ();
    SPI.setDataMode(SPI_MODE0);
    SPI.setHwCs(true);
    SPI.setBitOrder(LSBFIRST);
    SPI.setFrequency(4000000);

    // tutaj
    setDataBits (dataBits);
}
