stash-s/FunkNetzWerkUhr/(commit log)

2018-07-26 Initial commit.
    [controller.sch, funknetzwerkuhr.kicad_pcb, nixie-breakout-B.Cu.dxf, nixie-breakout-F.Cu.dxf, nixie-breakout.kicad_pcb, nixie-breakout.sch, nixie-zmiany.kicad_pcb]
2018-07-28 Pulled all into one schematic - don't know yet if this is a good idea.
    [circuit_calculations.ods, controller.sch, front_panel.sch, funknetzwerkuhr.kicad_pcb, funknetzwerkuhr.sch, hv_psu.sch, psu.sch]
2018-08-02 Schematic nearly done, need to add programming header.
    [front_panel.sch, funknetzwerkuhr.kicad_pcb, funknetzwerkuhr.sch, hv_psu.sch]
2018-08-02 Added 1st prototype of clock's brains.
    [funknetzwerkuhr.sch]
2018-08-05 Schematic complete. PCB nearly done.
    [front_panel.sch, funknetzwerkuhr.kicad_pcb, funknetzwerkuhr.sch]
2018-08-06 First final draft ready (Ausf B)
    [funknetzwerkuhr.kicad_pcb, funknetzwerkuhr.sch, hv_psu.sch]
2018-08-08 Nearly done.
    [funknetzwerkuhr.kicad_pcb]
2018-08-31 Nothing works now.
    [funknetzwerkuhr.kicad_pcb, funknetzwerkuhr.sch]
2018-09-02 Light sensor adjusts brightness to ambient light.
2018-09-03 Making place for new pcb (ausf c)
    [circuit_calculations.ods, controller.sch, front_panel.sch, funknetzwerkuhr.kicad_pcb, funknetzwerkuhr.sch, hv_psu.sch, nixie-breakout-B.Cu.dxf, nixie-breakout-F.Cu.dxf]
2018-09-09 PSU does not fit into the outline.
    [front_panel.sch, funknetzwerkuhr.kicad_pcb, funknetzwerkuhr.sch, hv_psu.sch]
2018-10-07 Refactored - create an abstract superclass
    [funknetzwerkuhr.kicad_pcb]
2018-10-21 Added slot machine effect.
2018-10-21 Restart after failed NTP connection attempts.
    [main.cpp]
2018-11-02 Added new hw revision.
    [ausf_d.kicad_pcb, ausf_d.sch]
2019-05-02 Nearly done Ausf C PCB layout.
    [front_panel.sch, funknetzwerkuhr.kicad_pcb, funknetzwerkuhr.sch, hv_psu.sch]
2019-05-03 Ausf C PCB version ordered.
    [funknetzwerkuhr-B_Cu.gbr, funknetzwerkuhr-B_Mask.gbr, funknetzwerkuhr-B_SilkS.gbr, funknetzwerkuhr-Edge_Cuts.gbr, funknetzwerkuhr-F_Cu.gbr, funknetzwerkuhr-F_Mask.gbr, funknetzwerkuhr-F_SilkS.gbr, funknetzwerkuhr-NPTH.drl]
2019-05-03 Additional save.
    [funknetzwerkuhr.kicad_pcb]
2019-05-12 First attempt at universal clock mainboard.
    [hv_psu.sch]
2019-05-12 Working version of ausf D is on the branch.
    [ausf_d.kicad_pcb, ausf_d.sch, filament_psu.sch, hv_psu.sch]
2019-05-14 Made version work with Ausf. A and Ausf. C
    [ausf_d.kicad_pcb, ausf_d.sch]
2020-11-01 Light Sensor fixed for Ausf B and C
    [clock_config.h, light_sensor.cpp, main.cpp]
2020-11-04 Removed temporary Kicad files.
2020-11-04 Minor edits
    [ausf_d.kicad_pcb, ausf_d.sch, filament_psu.sch, hv_psu.sch]
2020-11-05 Corrected 4 digit in ausf C version.
    [max_display.cpp]
2020-11-05 Opened ausf_c with newer Kicad version.
    [front_panel.sch, funknetzwerkuhr.kicad_pcb, funknetzwerkuhr.sch, hv_psu.sch]
2021-06-09 Switched from NTPClient to ezTime library
    [circuit_calculations.ods, funknetzwerkuhr.kicad_pcb, funknetzwerkuhr.sch, hv_psu.sch]
2021-06-09 Switch from NTPTime to ezTime library.
2021-06-09 Switched from NTPTime to ezTime
    [front_panel.sch, funknetzwerkuhr.kicad_pcb, funknetzwerkuhr.sch, hv_psu.sch]
2021-06-12 Switched to asynchronous web server and added endpoints to reset configuration.
    [delay.cpp, delay.hpp, main.cpp]
2021-11-27 Ausf C chassis ready
2021-11-27 Tweak lamp hole size
2022-11-16 Added Ausf C layout
    [front_panel.kicad_sch, funknetzwerkuhr.kicad_pcb, funknetzwerkuhr.kicad_sch, hv_psu.kicad_sch]
